mbasanta/VWS_SDR/VWS_SDR.kicad_pcb

## KiCad design VWS_SDR.kicad_pcb (2025-03-11)

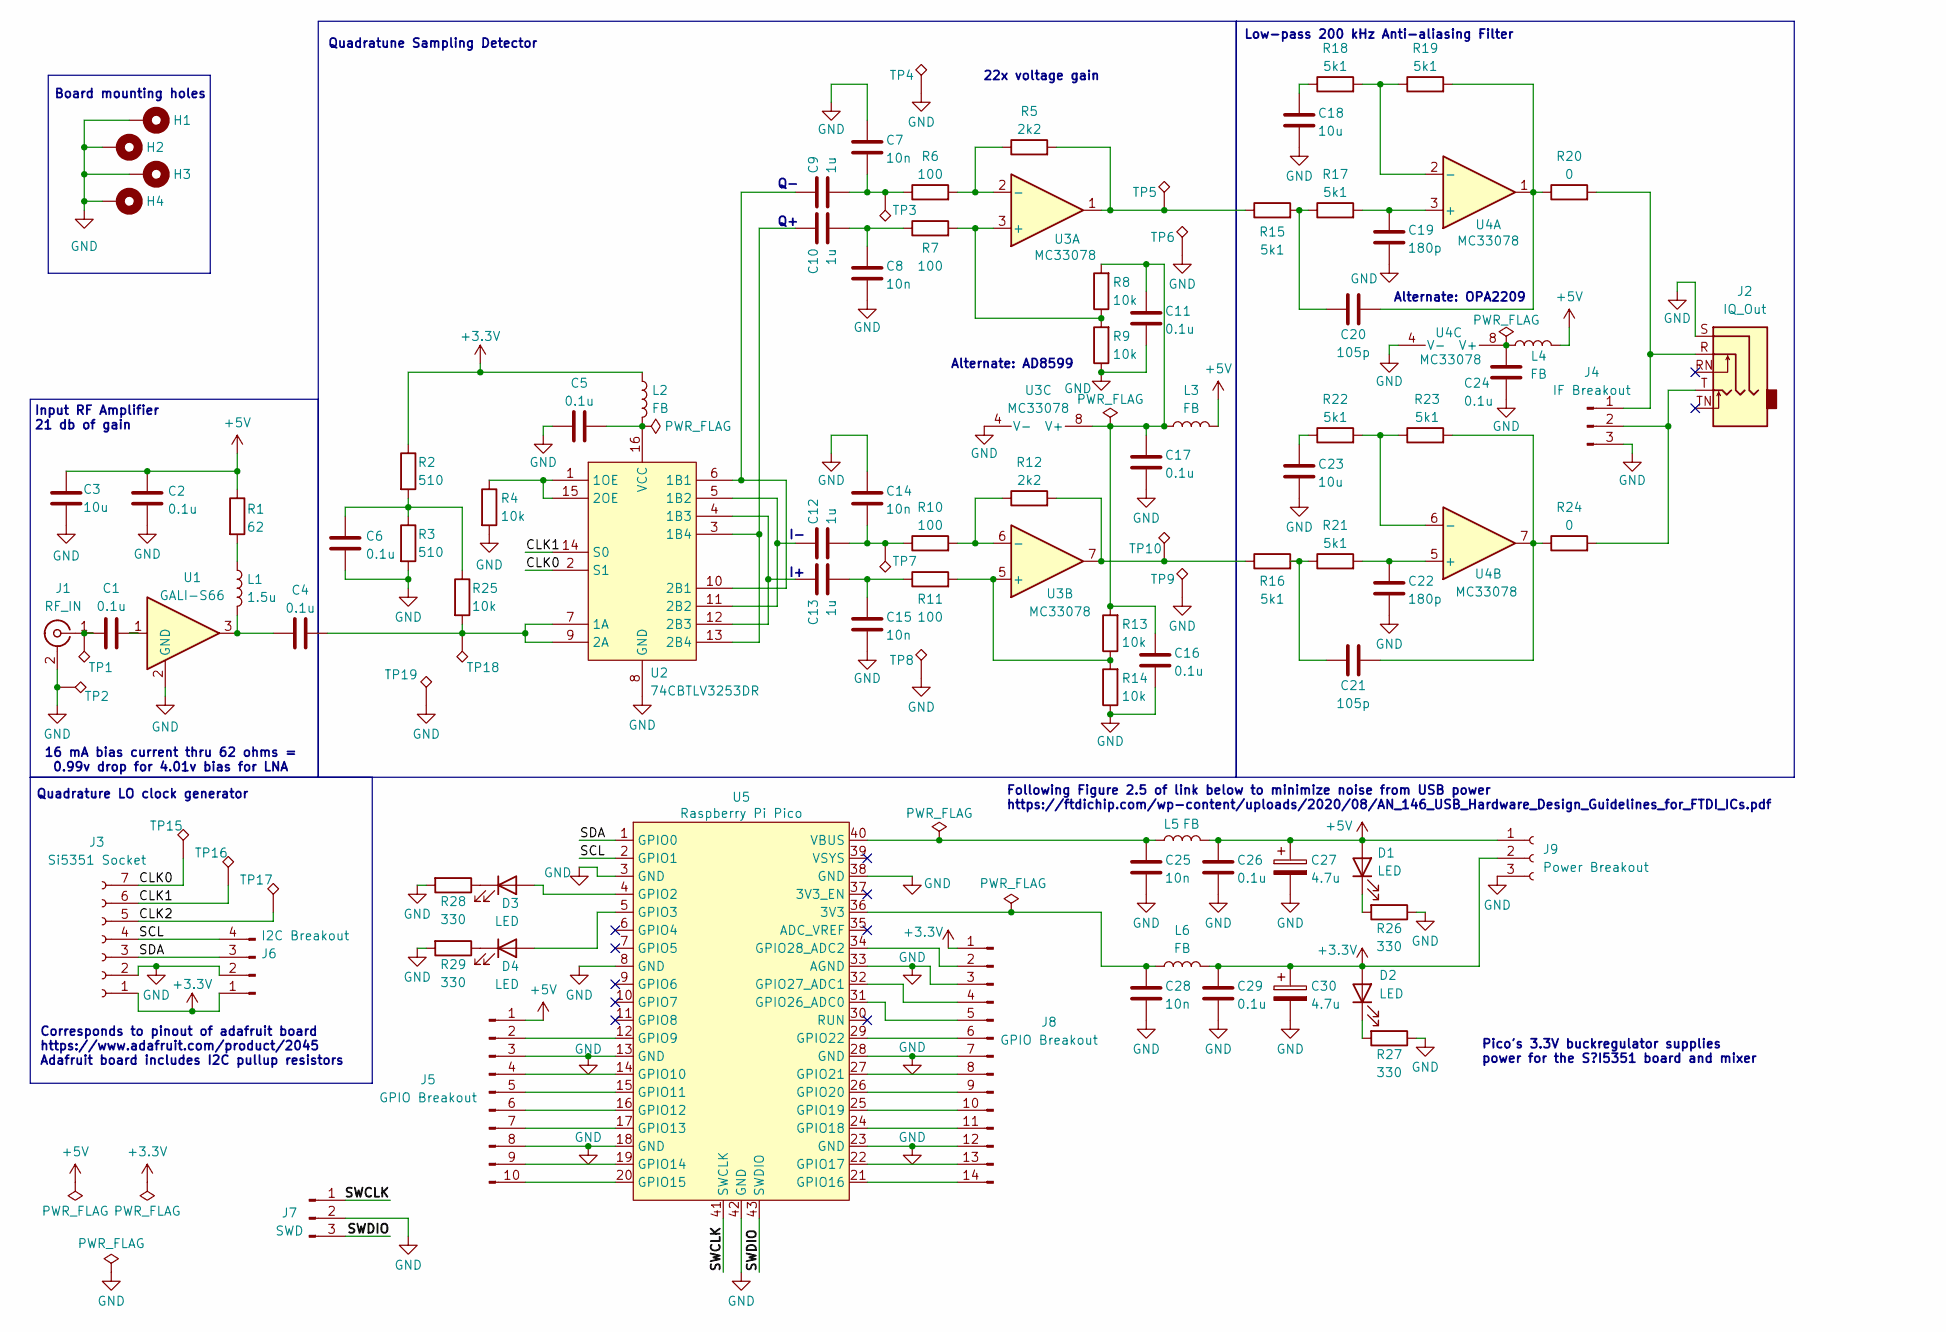
[picture p1: schematic VWS_SDR.kicad_sch, VWS HF SDR]

Parts:
C1, C2, C4, C5, C6, C11, C16, C17, C24, C26, C29: 0.1u; C_1206_3216Metric_Pad1.33x1.80mm_HandSolder; Digikey PN 399-C1206C104K5RACTUCT-ND
C3, C18, C23: 10u; C_1206_3216Metric_Pad1.33x1.80mm_HandSolder; Digikey PN 399-C1206C106K4RACTUCT-ND
C7, C8, C14, C15, C25, C28: 10n; C_1206_3216Metric_Pad1.33x1.80mm_HandSolder; Digikey PN 399-C1206C103K5RACTUCT-ND
C9, C10, C12, C13: 1u; C_1206_3216Metric_Pad1.33x1.80mm_HandSolder; Digikey PN 399-C1206C105K3RACTUCT-ND
C19, C22: 180p; C_1206_3216Metric_Pad1.33x1.80mm_HandSolder; Digikey PN 311-4412-1-ND
C20, C21: 105p; C_1206_3216Metric_Pad1.33x1.80mm_HandSolder; Digikey PN 399-17651-1-ND
C27, C30: 4.7u; CP_Radial_D5.0mm_P2.00mm; Digikey PN 399-ESW475M025AC3AA-ND
D1, D2: LED; LED_1206_3216Metric_Pad1.42x1.75mm_HandSolder; Digikey PN 732-4988-1-ND
D3: LED; LED_1206_3216Metric_Pad1.42x1.75mm_HandSolder; Digikey PN 732-4990-1-ND
D4: LED; LED_1206_3216Metric_Pad1.42x1.75mm_HandSolder; Digikey PN 732-4989-1-ND
H1, H2, H3, H4: MountingHole_Pad; MountingHole_3.2mm_M3_ISO7380_Pad
J1: RF_IN; SMA_Amphenol_901-144_Vertical; Digikey PN 2057-RF2-03E-T-00-50-G-ND
J2: IQ_Out; Jack_3.5mm_CUI_SJ1-3515N_Horizontal; Digikey PN CP1-3515N-ND
J3: Si5351 Socket; Adafruit_Si5351; Digikey PN 1528-1206-ND
J4: IF Breakout; PinHeader_1x03_P2.54mm_Vertical; Digikey PN 2057-RS1-03-G-ND
J5: GPIO Breakout; PinHeader_1x10_P2.54mm_Vertical; Digikey PN 2057-RS1-10-G-ND
J6: I2C Breakout; PinHeader_1x04_P2.54mm_Vertical; Digikey PN 2057-RS1-04-G-ND
J7: SWD; PinHeader_1x03_P2.54mm_Vertical; Digikey PN 2057-RS1-03-G-ND
J8: GPIO Breakout; PinHeader_1x14_P2.54mm_Vertical; Digikey PN 2057-RS1-14-G-ND
J9: Power Breakout; PinHeader_1x03_P2.54mm_Vertical; Digikey PN 2057-RS1-03-G-ND
L1: 1.5u; L_1206_3216Metric_Pad1.42x1.75mm_HandSolder; Digikey PN 541-ILSB1206ER1R5KCT-ND
L2, L3, L4, L5, L6: FB; L_1206_3216Metric_Pad1.42x1.75mm_HandSolder; Digikey PN 1934-1489-1-ND
R1: 62; R_1206_3216Metric_Pad1.30x1.75mm_HandSolder; Digikey PN 311-62ERCT-ND
R2, R3: 510; R_1206_3216Metric_Pad1.30x1.75mm_HandSolder; Digikey PN 311-510ERCT-ND
R4, R8, R9, R13, R14, R25: 10k; R_1206_3216Metric_Pad1.30x1.75mm_HandSolder; Digikey PN 311-10KERCT-ND
R5, R12: 2k2; R_1206_3216Metric_Pad1.30x1.75mm_HandSolder; Digikey PN 311-2.2KERCT-ND
R6, R7, R10, R11: 100; R_1206_3216Metric_Pad1.30x1.75mm_HandSolder; Digikey PN 311-100ERCT-ND
R15, R16, R17, R18, R19, R21, R22, R23: 5k1; R_1206_3216Metric_Pad1.30x1.75mm_HandSolder; Digikey PN 311-5.1KERCT-ND
R20, R24: 0; R_1206_3216Metric_Pad1.30x1.75mm_HandSolder; Digikey PN 311-0.0ERCT-ND
R26, R27, R28, R29: 330; R_1206_3216Metric_Pad1.30x1.75mm_HandSolder; Digikey PN 311-330ERCT-ND
TP1, TP2, TP3, TP4, TP5, TP6, TP7, TP8, TP9, TP10, TP15, TP16, TP17, TP18, TP19: TP1; TestPoint_THTPad_D2.0mm_Drill1.0mm
U1: GALI-S66; SOT-89-3; Digikey PN 3157-GALI-S66+CT-ND
U2: 74CBTLV3253DR; SOIC-16_3.9x9.9mm_P1.27mm; Digikey PN 296-9132-1-ND
U3, U4: MC33078; SOIC-8_3.9x4.9mm_P1.27mm; Digikey PN 497-1952-1-ND
U5: Raspberry Pi Pico; RPi_Pico_SMD_TH; Digikey PN 2648-SC0915CT-ND

Connections:
+3.3V: C29.1, C30.1, D2.2 (A), J3.1, J6.1, J8.1, J9.2, L2.1, L6.2, R2.1
+5V: C2.2, C3.2, C26.1, C27.1, D1.2 (A), J5.1, J9.1, L3.2, L4.2, L5.2, R1.1
/CLK0: J3.7, TP15.1, U2.2 (S1)
/CLK1: J3.6, TP16.1, U2.14 (S0)
/CLK2: J3.5, TP17.1
/SCL: J3.4, J6.4, U5.2 (GPIO1)
/SDA: J3.3, J6.3, U5.1 (GPIO0)
/SWCLK: J7.1, U5.41 (SWCLK)
/SWDIO: J7.3, U5.43 (SWDIO)
GND: C2.1, C3.1, C5.2, C6.2, C7.1, C8.2, C11.2, C14.1, C15.2, C16.2, C17.2, C18.2, C19.2, C22.2, C23.2, C24.2, C25.2, C26.2, C27.2, C28.2, C29.2, C30.2, H1.1, H2.1, H3.1, H4.1, J1.2 (Ext), J2.S, J3.2, J4.3, J5.3, J5.8, J6.2, J7.2, J8.3, J8.7, J8.12, J9.3, R3.2, R4.2, R9.1, R14.1, R26.1, R27.1, R28.2, R29.2, TP2.1, TP4.1, TP6.1, TP8.1, TP9.1, TP19.1, U1.2 (GND), U2.8 (GND), U3.4 (V-), U4.4 (V-), U5.3 (GND), U5.8 (GND), U5.13 (GND), U5.18 (GND), U5.23 (GND), U5.28 (GND), U5.33 (AGND), U5.38 (GND), U5.42 (GND)
unnamed: C1.2, U1.1
unnamed: C4.2, L1.2, U1.3
unnamed: C6.1, R2.2, R3.1, R25.1
unnamed: C7.2, C9.2, R6.1, TP3.1
unnamed: C8.1, C10.2, R7.1
unnamed: C12.2, C14.2, R10.1, TP7.1
unnamed: C13.2, C15.1, R11.1
unnamed: C18.1, R18.1
unnamed: C20.1, R19.2, R20.1, U4.1
unnamed: C20.2, R15.2, R17.1
unnamed: C21.1, R23.2, R24.1, U4.7
unnamed: C21.2, R16.2, R21.1
unnamed: C23.1, R22.1
unnamed: D1.1 (K), R26.2
unnamed: D2.1 (K), R27.2
unnamed: D3.2 (A), U5.4 (GPIO2)
unnamed: D3.1 (K), R28.1
unnamed: D4.2 (A), U5.5 (GPIO3)
unnamed: D4.1 (K), R29.1
unnamed: C1.1, J1.1 (In), TP1.1
unnamed: J2.R, J4.1, R20.2
unnamed: J2.T, J4.2, R24.2
unnamed: J5.2, U5.12 (GPIO9)
unnamed: J5.4, U5.14 (GPIO10)
unnamed: J5.5, U5.15 (GPIO11)
unnamed: J5.6, U5.16 (GPIO12)
unnamed: J5.7, U5.17 (GPIO13)
unnamed: J5.9, U5.19 (GPIO14)
unnamed: J5.10, U5.20 (GPIO15)
unnamed: J8.2, U5.34 (GPIO28_ADC2)
unnamed: J8.4, U5.32 (GPIO27_ADC1)
unnamed: J8.5, U5.31 (GPIO26_ADC0)
unnamed: J8.6, U5.29 (GPIO22)
unnamed: J8.8, U5.27 (GPIO21)
unnamed: J8.9, U5.26 (GPIO20)
unnamed: J8.10, U5.25 (GPIO19)
unnamed: J8.11, U5.24 (GPIO18)
unnamed: J8.13, U5.22 (GPIO17)
unnamed: J8.14, U5.21 (GPIO16)
unnamed: L1.1, R1.2
unnamed: R12.2, R16.1, TP10.1, U3.7
unnamed: R5.2, R15.1, TP5.1, U3.1
unnamed: C4.1, R25.2, TP18.1, U2.7 (1A), U2.9 (2A)
unnamed: C9.1, U2.6 (1B1), U2.10 (2B1)
unnamed: C12.1, U2.5 (1B2), U2.11 (2B2)
unnamed: C13.1, U2.4 (1B3), U2.12 (2B3)
unnamed: C10.1, U2.3 (1B4), U2.13 (2B4)
unnamed: R4.1, U2.1 (1OE), U2.15 (2OE)
unnamed: C5.1, L2.2, U2.16 (VCC)
unnamed: R7.2, R8.1, R9.2, U3.3 (+)
unnamed: R5.1, R6.2, U3.2 (-)
unnamed: R11.2, R13.1, R14.2, U3.5 (+)
unnamed: R10.2, R12.1, U3.6 (-)
unnamed: C11.1, C16.1, C17.1, L3.1, R8.2, R13.2, U3.8 (V+)
unnamed: C19.1, R17.2, U4.3 (+)
unnamed: R18.2, R19.1, U4.2 (-)
unnamed: C22.1, R21.2, U4.5 (+)
unnamed: R22.2, R23.1, U4.6 (-)
unnamed: C24.1, L4.1, U4.8 (V+)
unnamed: C28.1, L6.1, U5.36 (3V3)
unnamed: C25.1, L5.1, U5.40 (VBUS)

Notes on the sheet:
Alternate: OPA2209
Following Figure 2.5 of link below to minimize noise from USB power https://ftdichip.com/wp-content/uploads/2020/08/AN_146_USB_Hardware_Design_Guidelines_for_FTDI_ICs.pdf
Input RF Amplifier 21 db of gain
22x voltage gain
Corresponds to pinout of adafruit board https://www.adafruit.com/product/2045 Adafruit board includes I2C pullup resistors
16 mA bias current thru 62 ohms = 0.99v drop for 4.01v bias for LNA
Quadratune Sampling Detector
Quadrature LO clock generator
Alternate: AD8599
Pico's 3.3V buckregulator supplies power for the S?I5351 board and mixer
Board mounting holes
Low-pass 200 kHz Anti-aliasing Filter

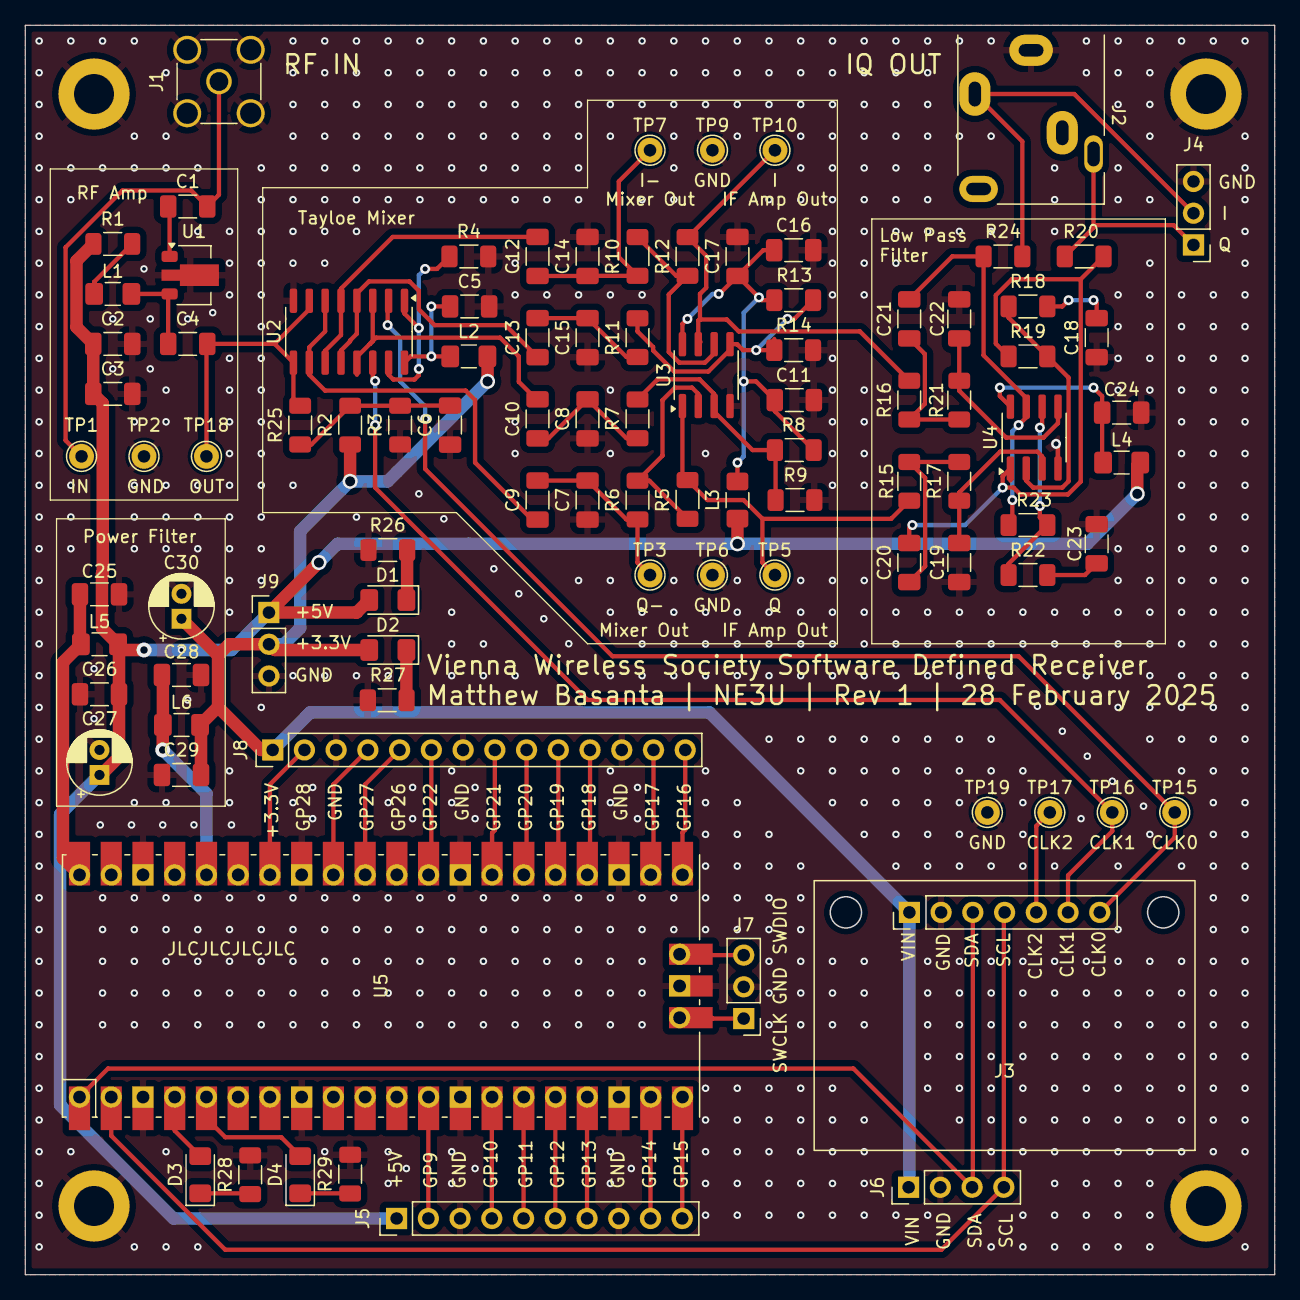
[picture p2: board VWS_SDR.kicad_pcb from above]

Board: 4 copper layers, 100.0 x 100.0 mm, 100 parts (0 on the bottom side), 71 nets.
